mirkoruether/lathecontrol/README.md

# Pimp your lathe!
bla bla will be added later.

## Software Libraries
#### RotaryEncoder
https://github.com/mathertel/RotaryEncoder \
http://www.mathertel.de/Arduino/RotaryEncoderLibrary.aspx 

#### Display
http://www.lcdwiki.com/3.5inch_Arduino_Display-UNO#Program_Download \
https://github.com/lcdwiki/LCDWIKI_gui \
https://github.com/lcdwiki/LCDWIKI_kbv \
https://github.com/adafruit/Adafruit_TouchScreen 

## Hardware
#### Measuring Sticks (German):
https://www.wabeco-remscheid.de/catalog/category/view/s/anbaumessschieber/id/562/

#### Arduino Mega2560:
https://store.arduino.cc/arduino-mega-2560-rev3

#### Display
http://www.lcdwiki.com/3.5inch_Arduino_Display-UNO \
https://www.amazon.de/gp/product/B07K2YCSJD/ 

## Other Links
#### Very helpful project
http://www.mtahlers.de/index.php/diverses/messschieberanzeige
