mirkoruether/lathecontrol/v3_rp2040/board/lathecontrol_v3.kicad_pcb

## KiCad design v3_rp2040/board/lathecontrol_v3.kicad_pcb (2026-09-24)

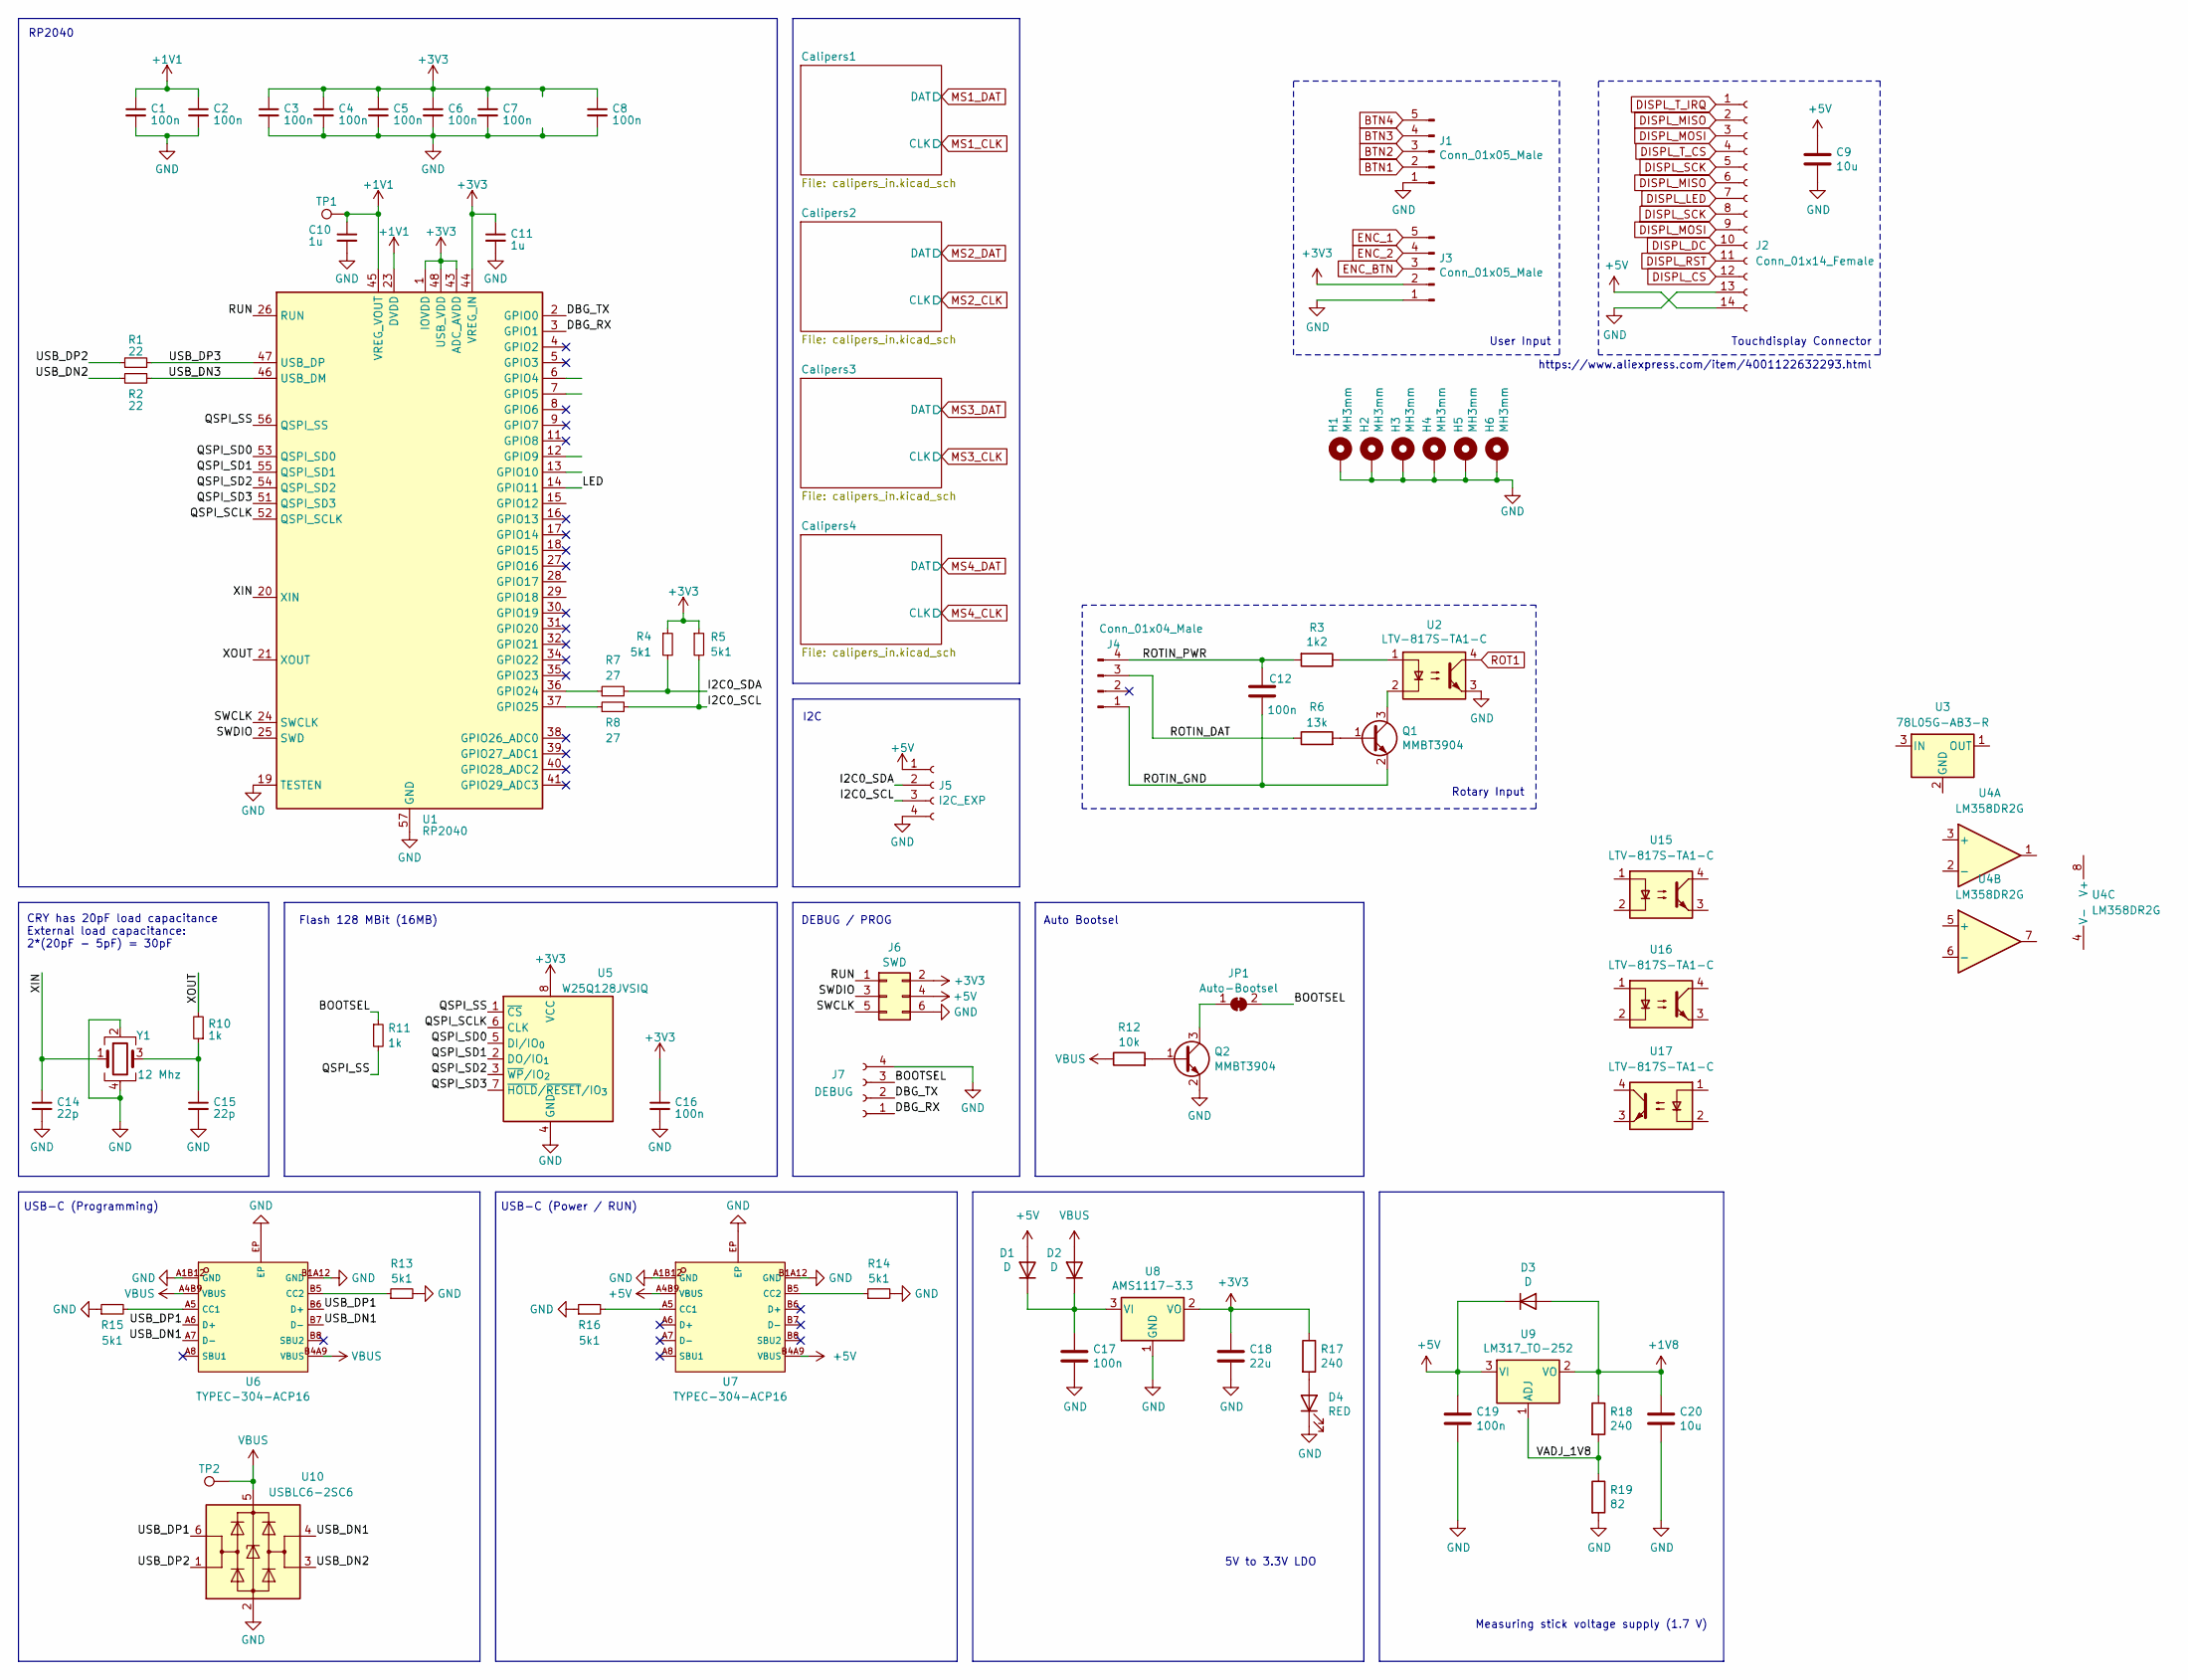
[picture p1: schematic lathecontrol_v3.kicad_sch]

Parts:
C1, C2, C3, C4, C5, C6, C7, C8, C16: 100n; C_0402_1005Metric; LCSC C1525
C9, C20: 10u; C_0805_2012Metric; LCSC C13585
C10, C11: 1u; C_0402_1005Metric; LCSC C52923
C12, C17, C19: 100n; C_0603_1608Metric; LCSC C14663
C14, C15: 22p; C_0402_1005Metric; LCSC C1555
C18: 22u; C_0805_2012Metric; LCSC C45783
D1, D2, D3: D; D_SOD-123F; LCSC C64898
D4: RED; LED_0603_1608Metric; LCSC C2286
H1, H2, H3, H4, H5, H6: MH3mm; MountingHole_3mm_Pad
J1: Conn_01x05_Male; PinHeader_1x06_P2.54mm_Horizontal
J2: Conn_01x14_Female; PinSocket_1x14_P2.54mm_Vertical
J3: Conn_01x05_Male; PinHeader_1x05_P2.54mm_Horizontal
J4: Conn_01x04_Male; PinHeader_1x04_P2.54mm_Horizontal
J5: I2C_EXP; PinHeader_1x04_P2.54mm_Vertical; LCSC C2691448
J6: SWD; PinHeader_2x03_P2.54mm_Vertical; LCSC C65114
J7: DEBUG; PinHeader_1x04_P2.54mm_Vertical; LCSC C2691448
JP1: Auto-Bootsel; R_0603_1608Metric; LCSC C21189
Q1: MMBT3904; SOT-23
Q2: MMBT3904; SOT-23; LCSC C20526
R1, R2: 22; R_0402_1005Metric; LCSC C25092
R3: 1k2; R_0805_2012Metric; LCSC C17379
R4, R5, R13, R14, R15, R16: 5k1; R_0603_1608Metric; LCSC C23186
R6: 13k; R_0603_1608Metric; LCSC C22797
R7, R8: 27; R_0603_1608Metric; LCSC C25190
R10, R11: 1k; R_0402_1005Metric; LCSC C11702
R12: 10k; R_0402_1005Metric; LCSC C25744
R17, R18: 240; R_0603_1608Metric; LCSC C23350
R19: 82; R_0603_1608Metric; LCSC C23255
TP1, TP2: TestPoint; TestPoint_Pad_D1.5mm
U1: RP2040; RP2040-QFN-56; LCSC C2040
U2, U15, U16, U17: LTV-817S-TA1-C; SMDIP-4_W9.53mm; LCSC C109227
U3: 78L05G-AB3-R; SOT-89-3; LCSC C71136
U4: LM358DR2G; SOIC-8_3.9x4.9mm_P1.27mm; LCSC C7950
U5: W25Q128JVSIQ; SOIC-8_5.3x5.3mm_P1.27mm; LCSC C97521
U6, U7: TYPEC-304-ACP16; USB-C-SMD_TYPE-C-16P-1; LCSC C2982555
U8: AMS1117-3.3; SOT-223-3_TabPin2; LCSC C6186
U9: LM317_TO-252; TO-252-2; LCSC C75510
U10: USBLC6-2SC6; SOT-23-6; LCSC C2827654
Y1: 12 Mhz; OSC-SMD_4P-L3.2-W2.5-BL; LCSC C9002

Connections:
+1V1: C1.1, C2.1, C10.1, TP1.1 (1_1), U1.23 (DVDD), U1.45 (VREG_VOUT), U1.50 (DVDD)
+1V8: C20.1, D3.2 (A), R18.1, U9.2 (VO); also elsewhere on the board
+3V3: C3.1, C4.1, C5.1, C6.1, C7.1, C8.1, C11.1, C16.1, C18.1, J3.2, J6.2, R4.1, R5.1, R17.1, U1.1 (IOVDD), U1.10 (IOVDD), U1.22 (IOVDD), U1.33 (IOVDD), U1.42 (IOVDD), U1.43 (ADC_AVDD), U1.44 (VREG_IN), U1.48 (USB_VDD), U1.49 (IOVDD), U5.8 (VCC), U8.2 (VO); also elsewhere on the board
+5V: C9.1, C19.1, D1.2 (A), D3.1 (K), J2.14, J5.1, J6.4, U7.A4B9 (VBUS), U7.B4A9 (VBUS), U9.3 (VI)
/BOOTSEL: J7.3, JP1.2 (B), R11.1
/DBG_RX: J7.1, U1.3 (GPIO1)
/DBG_TX: J7.2, U1.2 (GPIO0)
/I2C0_SCL: J5.3, R5.2, R8.2
/I2C0_SDA: J5.2, R4.2, R7.2
/LED: U1.14 (GPIO11)
/QSPI_SCLK: U1.52 (QSPI_SCLK), U5.6 (CLK)
/QSPI_SD0: U1.53 (QSPI_SD0), U5.5 (DI/IO_{0})
/QSPI_SD1: U1.55 (QSPI_SD1), U5.2 (DO/IO_{1})
/QSPI_SD2: U1.54 (QSPI_SD2), U5.3 (~WP/IO_{2})
/QSPI_SD3: U1.51 (QSPI_SD3), U5.7 (~HOLD/~RESET/IO_{3})
/QSPI_SS: R11.2, U1.56 (QSPI_SS), U5.1 (~CS)
/ROTIN_DAT: J4.3, R6.1
/ROTIN_GND: C12.2, J4.1, Q1.2 (E)
/ROTIN_PWR: C12.1, J4.4, R3.2
/RUN: J6.1, U1.26 (RUN)
/SWCLK: J6.5, U1.24 (SWCLK)
/SWDIO: J6.3, U1.25 (SWD)
/USB_DN1: U6.A7 (D-), U6.B7 (D-), U10.4 (I/O2)
/USB_DN2: R2.2, U10.3 (I/O2)
/USB_DN3: R2.1, U1.46 (USB_DM)
/USB_DP1: U6.A6 (D+), U6.B6 (D+), U10.6 (I/O1)
/USB_DP2: R1.1, U10.1 (I/O1)
/USB_DP3: R1.2, U1.47 (USB_DP)
/VADJ_1V8: R18.2, R19.1, U9.1 (ADJ)
/XIN: C14.1, U1.20 (XIN), Y1.1
/XOUT: R10.2, U1.21 (XOUT)
BTN1: J1.2
BTN2: J1.3
BTN3: J1.4
BTN4: J1.5
DISPL_CS: J2.12
DISPL_DC: J2.10
DISPL_LED: J2.7
DISPL_MISO: J2.2, J2.6
DISPL_MOSI: J2.3, J2.9
DISPL_RST: J2.11
DISPL_SCK: J2.5, J2.8
DISPL_T_CS: J2.4
DISPL_T_IRQ: J2.1
ENC_1: J3.5
ENC_2: J3.4
ENC_BTN: J3.3
GND: C1.2, C2.2, C3.2, C4.2, C5.2, C6.2, C7.2, C8.2, C9.2, C10.2, C11.2, C14.2, C15.2, C16.2, C17.2, C18.2, C19.2, C20.2, D4.1 (K), H1.1 (1_1), H2.1 (1_1), H3.1 (1_1), H4.1 (1_1), H5.1 (1_1), H6.1 (1_1), J1.1, J2.13, J3.1, J5.4, J6.6, J7.4, Q2.2 (E), R13.2, R14.2, R15.1, R16.1, R19.2, U1.19 (TESTEN), U1.57 (GND), U2.3, U5.4 (GND), U6.A1B12 (GND), U6.B1A12 (GND), U6.EP, U7.A1B12 (GND), U7.B1A12 (GND), U7.EP, U8.1 (GND), U10.2 (GND), Y1.2, Y1.4; also elsewhere on the board
unnamed: C15.1, R10.1, Y1.3
unnamed: C17.1, D1.1 (K), D2.1 (K), U8.3 (VI)
unnamed: D4.2 (A), R17.2
unnamed: JP1.1 (A), Q2.3 (C)
unnamed: Q1.1 (B), R6.2
unnamed: Q1.3 (C), U2.2
unnamed: Q2.1 (B), R12.2
unnamed: R3.1, U2.1
unnamed: R7.1, U1.36 (GPIO24)
unnamed: R8.1, U1.37 (GPIO25)
unnamed: R15.2, U6.A5 (CC1)
unnamed: R13.1, U6.B5 (CC2)
unnamed: R16.2, U7.A5 (CC1)
unnamed: R14.1, U7.B5 (CC2)
ROT1: U2.4
VBUS: D2.2 (A), R12.1, TP2.1 (1_1), U6.A4B9 (VBUS), U6.B4A9 (VBUS), U10.5 (VBUS)

Notes on the sheet:
5V to 3.3V LDO
RP2040
Rotary Input
Flash 128 MBit (16MB)
https://www.aliexpress.com/item/4001122632293.html
USB-C (Programming)
Touchdisplay Connector
I2C
CRY has 20pF load capacitance External load capacitance: 2*(20pF - 5pF) = 30pF
Measuring stick voltage supply (1.7 V)
Auto Bootsel
USB-C (Power / RUN)
User Input
DEBUG / PROG

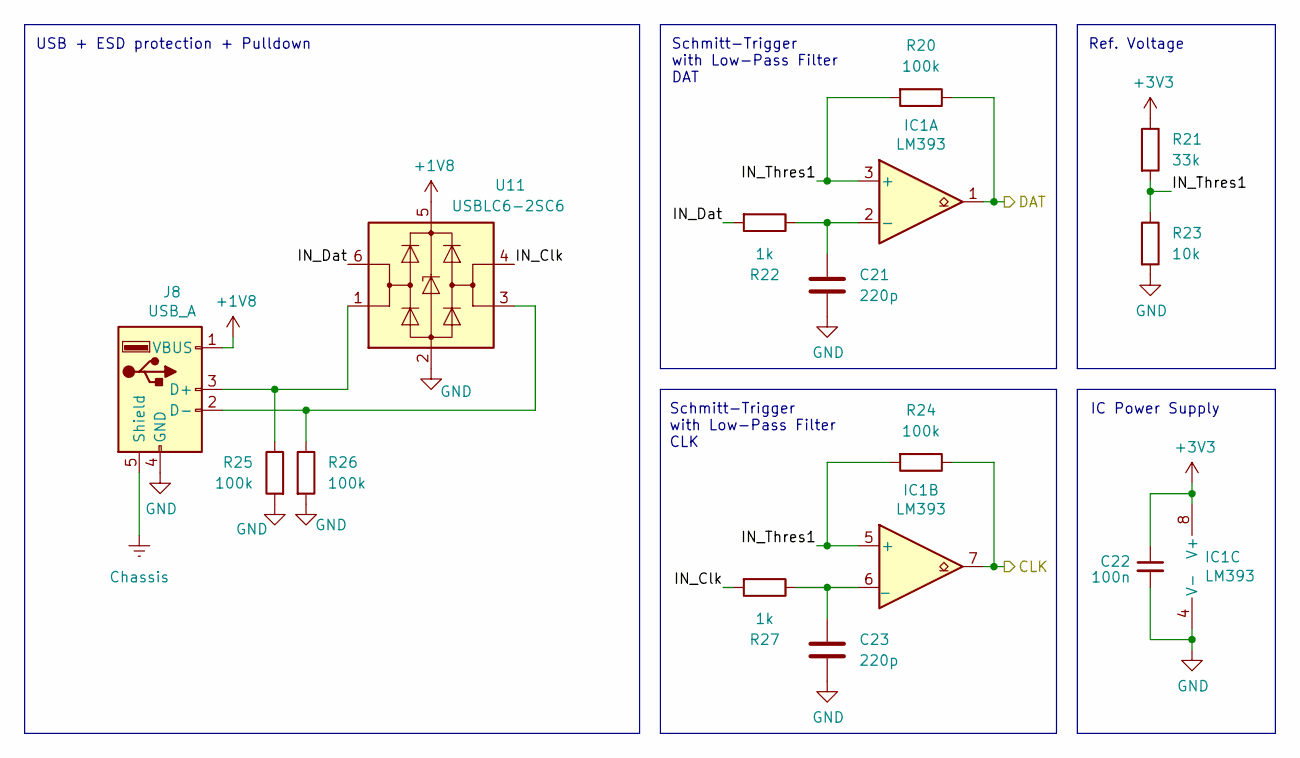
[picture p2: schematic calipers_in.kicad_sch]

Parts:
C21, C23: 220p; C_0402_1005Metric; LCSC C1530
C22: 100n; C_0402_1005Metric; LCSC C1525
IC1: LM393; SOIC-8_3.9x4.9mm_P1.27mm
J8: USB_A; USB_A_Upright_C26235; LCSC C26235
R20, R24, R25, R26: 100k; R_0402_1005Metric; LCSC C25741
R21: 33k; R_0402_1005Metric; LCSC C25779
R22, R27: 1k; R_0402_1005Metric; LCSC C11702
R23: 10k; R_0402_1005Metric; LCSC C25744
U11: USBLC6-2SC6; SOT-23-6; LCSC C2827654

Connections:
+1V8: J8.1 (VBUS), U11.5 (VBUS); also elsewhere on the board
+3V3: C22.1, IC1.8 (V+), R21.1; also elsewhere on the board
/Calipers1/IN_Clk: R27.2, U11.4 (I/O2)
/Calipers1/IN_Dat: R22.2, U11.6 (I/O1)
/Calipers1/IN_Thres1: IC1.3 (+), IC1.5 (+), R20.2, R21.2, R23.1, R24.2
Chassis: J8.5 (Shield); also elsewhere on the board
GND: C21.2, C22.2, C23.2, IC1.4 (V-), J8.4 (GND), R23.2, R25.2, R26.2, U11.2 (GND); also elsewhere on the board
MS1_CLK: IC1.7, R24.1
MS1_DAT: IC1.1, R20.1
unnamed: C21.1, IC1.2 (-), R22.1
unnamed: C23.1, IC1.6 (_), R27.1
unnamed: J8.3 (D+), R25.1, U11.1 (I/O1)
unnamed: J8.2 (D-), R26.1, U11.3 (I/O2)

Parts of its further copies:
C24, C26, C27, C29, C30, C32: 220p; C_0402_1005Metric; LCSC C1530
C25, C28, C31: 100n; C_0402_1005Metric; LCSC C1525
IC2, IC3, IC4: LM393; SOIC-8_3.9x4.9mm_P1.27mm
J9, J10, J11: USB_A; USB_A_Upright_C26235; LCSC C26235
R28, R32, R33, R34, R36, R40, R41, R42, R44, R48, R49, R50: 100k; R_0402_1005Metric; LCSC C25741
R29, R37, R45: 33k; R_0402_1005Metric; LCSC C25779
R30, R35, R38, R43, R46, R51: 1k; R_0402_1005Metric; LCSC C11702
R31, R39, R47: 10k; R_0402_1005Metric; LCSC C25744
U12, U13, U14: USBLC6-2SC6; SOT-23-6; LCSC C2827654

Connections of its further copies:
+1V8: J9.1 (VBUS), J10.1 (VBUS), J11.1 (VBUS), U12.5 (VBUS), U13.5 (VBUS), U14.5 (VBUS); also elsewhere on the board
+3V3: C25.1, C28.1, C31.1, IC2.8 (V+), IC3.8 (V+), IC4.8 (V+), R29.1, R37.1, R45.1; also elsewhere on the board
/Calipers2/IN_Clk: R35.2, U12.4 (I/O2)
/Calipers2/IN_Dat: R30.2, U12.6 (I/O1)
/Calipers2/IN_Thres1: IC2.3 (+), IC2.5 (+), R28.2, R29.2, R31.1, R32.2
/Calipers3/IN_Clk: R43.2, U13.4 (I/O2)
/Calipers3/IN_Dat: R38.2, U13.6 (I/O1)
/Calipers3/IN_Thres1: IC3.3 (+), IC3.5 (+), R36.2, R37.2, R39.1, R40.2
/Calipers4/IN_Clk: R51.2, U14.4 (I/O2)
/Calipers4/IN_Dat: R46.2, U14.6 (I/O1)
/Calipers4/IN_Thres1: IC4.3 (+), IC4.5 (+), R44.2, R45.2, R47.1, R48.2
Chassis: J9.5 (Shield), J10.5 (Shield), J11.5 (Shield); also elsewhere on the board
GND: C24.2, C25.2, C26.2, C27.2, C28.2, C29.2, C30.2, C31.2, C32.2, IC2.4 (V-), IC3.4 (V-), IC4.4 (V-), J9.4 (GND), J10.4 (GND), J11.4 (GND), R31.2, R33.2, R34.2, R39.2, R41.2, R42.2, R47.2, R49.2, R50.2, U12.2 (GND), U13.2 (GND), U14.2 (GND); also elsewhere on the board
MS2_CLK: IC2.7, R32.1
MS2_DAT: IC2.1, R28.1
MS3_CLK: IC3.7, R40.1
MS3_DAT: IC3.1, R36.1
MS4_CLK: IC4.7, R48.1
MS4_DAT: IC4.1, R44.1
unnamed: C24.1, IC2.2 (-), R30.1
unnamed: C26.1, IC2.6 (_), R35.1
unnamed: C27.1, IC3.2 (-), R38.1
unnamed: C29.1, IC3.6 (_), R43.1
unnamed: C30.1, IC4.2 (-), R46.1
unnamed: C32.1, IC4.6 (_), R51.1
unnamed: J9.3 (D+), R33.1, U12.1 (I/O1)
unnamed: J9.2 (D-), R34.1, U12.3 (I/O2)
unnamed: J10.3 (D+), R41.1, U13.1 (I/O1)
unnamed: J10.2 (D-), R42.1, U13.3 (I/O2)
unnamed: J11.3 (D+), R49.1, U14.1 (I/O1)
unnamed: J11.2 (D-), R50.1, U14.3 (I/O2)

Notes on the sheet:
IC Power Supply
Schmitt-Trigger with Low-Pass Filter DAT
USB + ESD protection + Pulldown
Schmitt-Trigger with Low-Pass Filter CLK
Ref. Voltage

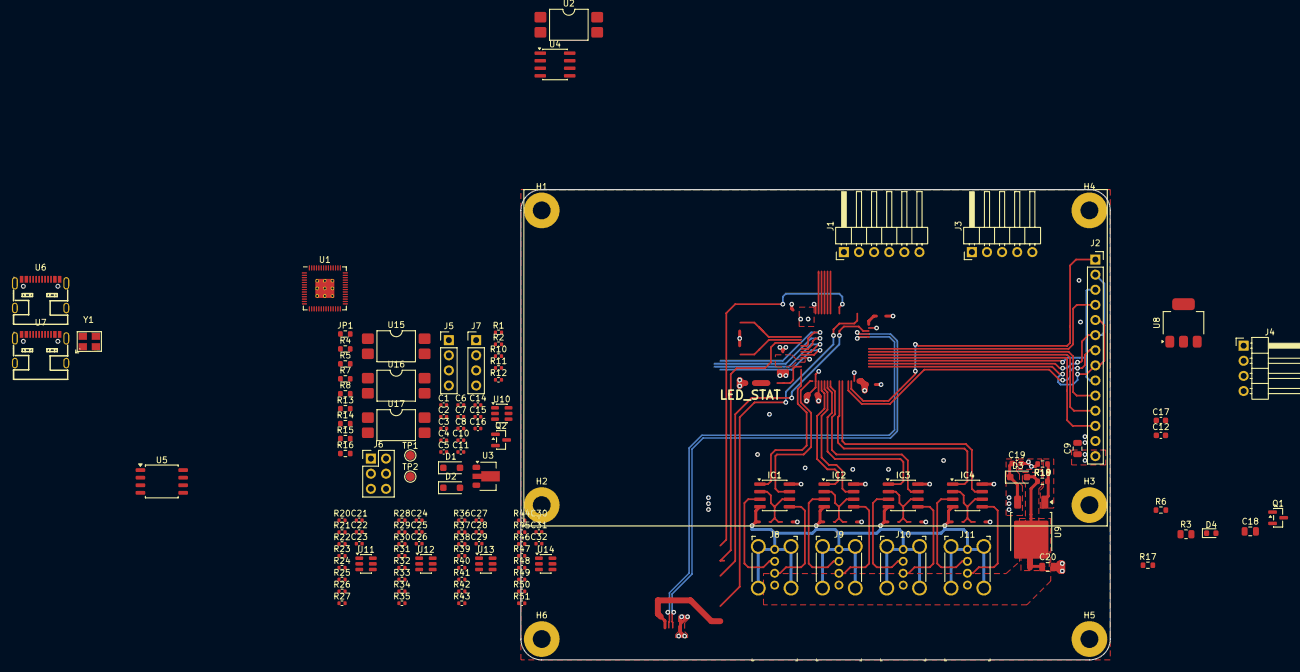
[picture p3: board lathecontrol_v3.kicad_pcb from above]

Board: 4 copper layers, 99.0 x 79.0 mm, 129 parts (0 on the bottom side), 86 nets.
