mirkoruether/lathecontrol/v2_stm32/board/lathecontrol_v2.kicad_pcb

## KiCad design v2_stm32/board/lathecontrol_v2.kicad_pcb (2022-01-29)

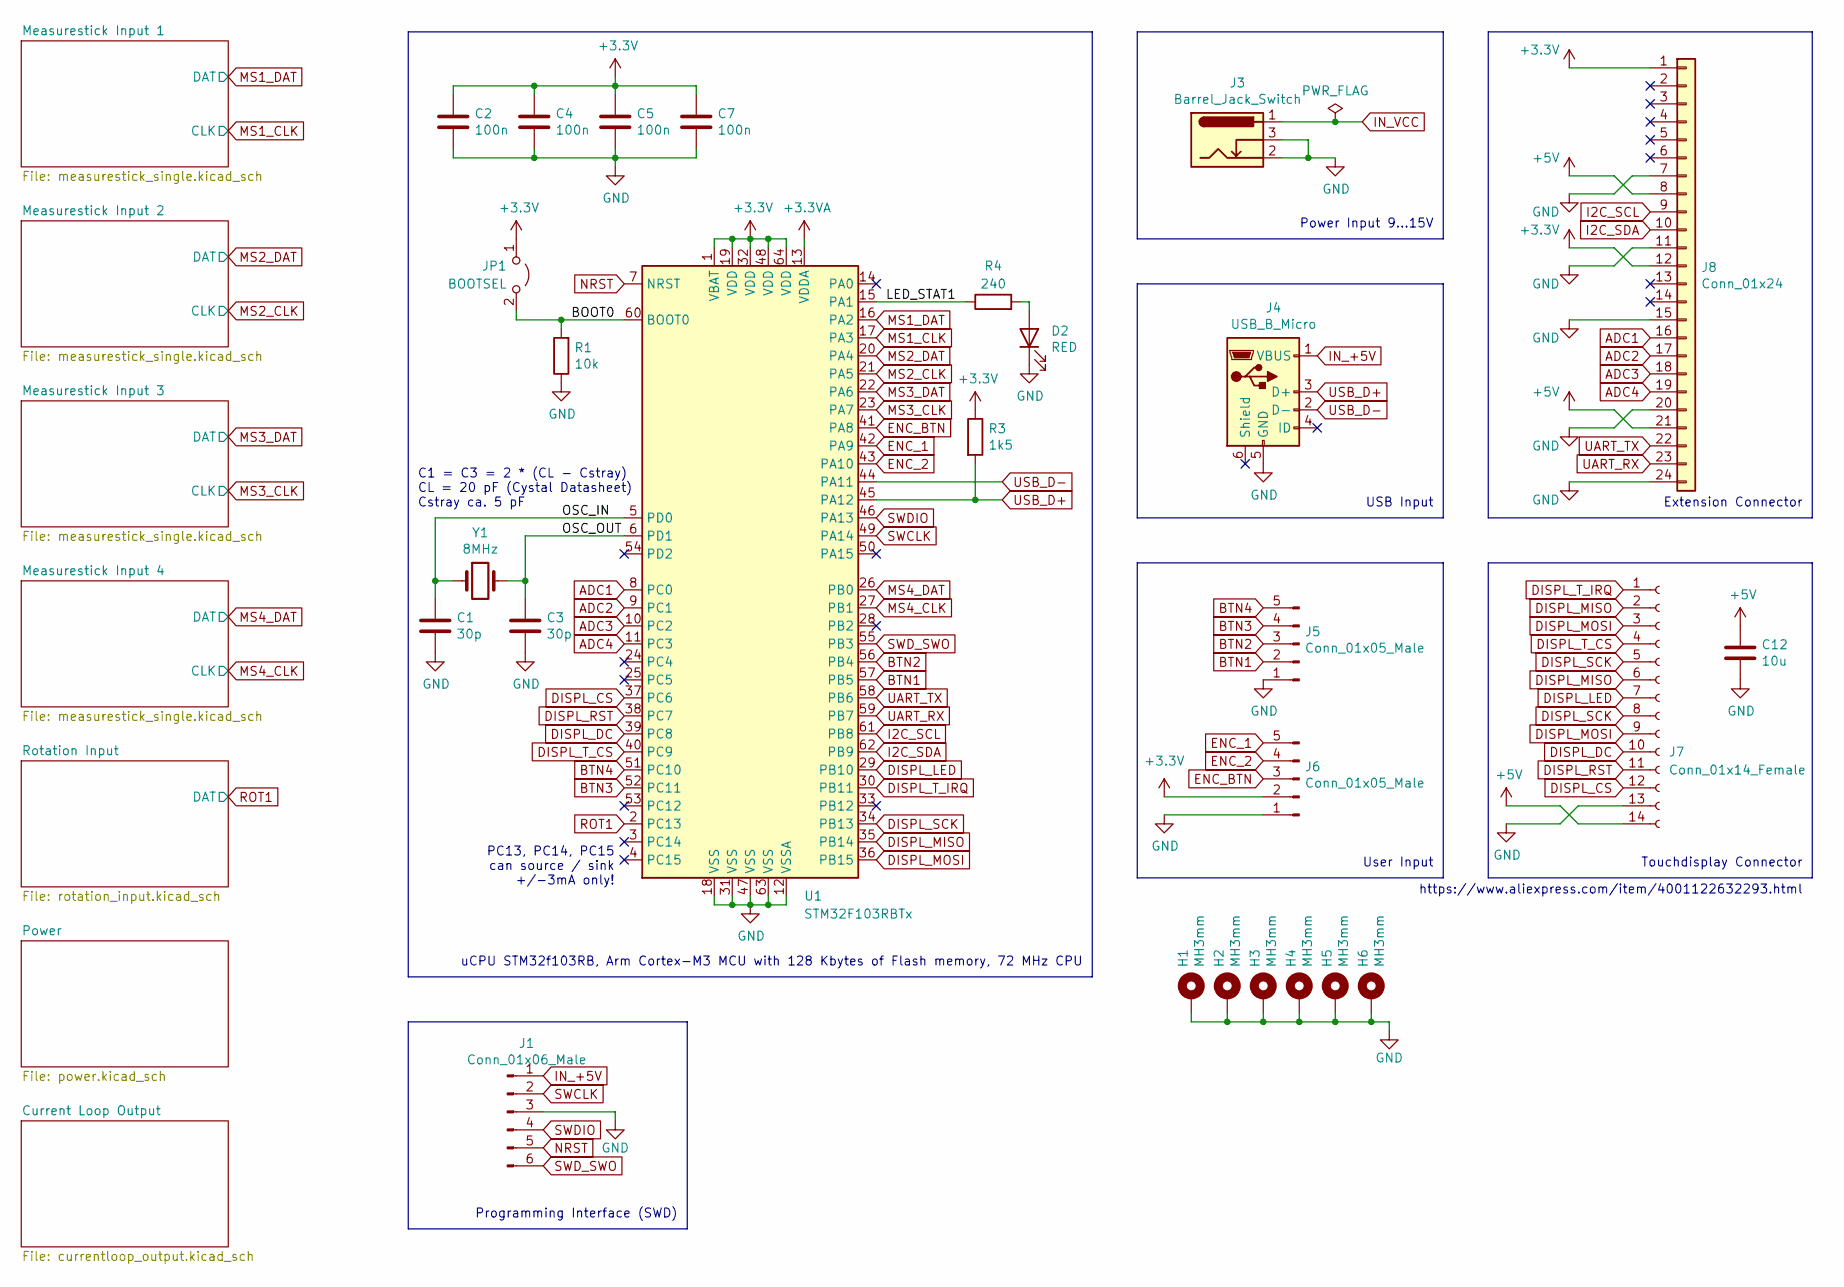
[picture p4: schematic lathecontrol_v2.kicad_sch]

Parts:
C1, C3: 30p; C_0603_1608Metric; LCSC C22397
C2, C4, C5, C7: 100n; C_0603_1608Metric; LCSC C14663
C12: 10u; C_0805_2012Metric; LCSC C13585
D2: RED; LED_0603_1608Metric; LCSC C2286
H1, H2, H3, H4, H5, H6: MH3mm; MountingHole_3mm_Pad
J1: Conn_01x06_Male; PinHeader_1x06_P2.54mm_Vertical
J3: Barrel_Jack_Switch; BarrelJack_Horizontal_DC-005-20A; LCSC C136744
J4: USB_B_Micro; USB_Micro-B_SHOU_HAN_MicroXNJ; LCSC C404969
J5: Conn_01x05_Male; PinHeader_1x06_P2.54mm_Horizontal
J6: Conn_01x05_Male; PinHeader_1x05_P2.54mm_Horizontal
J7: Conn_01x14_Female; PinSocket_1x14_P2.54mm_Vertical
J8: Conn_01x24; FFC_FPC_1x24_DualSide_JUSHUO_AFC24-S24FIC-00; LCSC C262292
JP1: BOOTSEL; PinHeader_1x02_P2.54mm_Horizontal
R1: 10k; R_0603_1608Metric; LCSC C25804
R3: 1k5; R_0603_1608Metric; LCSC C22843
R4: 240; R_0603_1608Metric; LCSC C23350
U1: STM32F103RBTx; LQFP-64_10x10mm_P0.5mm
Y1: 8MHz; Crystal_SMD_5032-2Pin_5.0x3.2mm; LCSC C115962

Connections:
+3.3VA: U1.13 (VDDA); also elsewhere on the board
+3V3: C2.1, C4.1, C5.1, C7.1, J6.2, J8.1, J8.12, JP1.1 (A), R3.1, U1.1 (VBAT), U1.19 (VDD), U1.32 (VDD), U1.48 (VDD), U1.64 (VDD); also elsewhere on the board
+5V: C12.1, J7.14, J8.8, J8.21; also elsewhere on the board
/BOOT0: JP1.2 (B), R1.2, U1.60 (BOOT0)
/LED_STAT1: R4.1, U1.15 (PA1)
/OSC_IN: C1.1, U1.5 (PD0), Y1.1
/OSC_OUT: C3.1, U1.6 (PD1), Y1.2
ADC1: J8.16, U1.8 (PC0)
ADC2: J8.17, U1.9 (PC1)
ADC3: J8.18, U1.10 (PC2)
ADC4: J8.19, U1.11 (PC3)
BTN1: J5.2, U1.57 (PB5)
BTN2: J5.3, U1.56 (PB4)
BTN3: J5.4, U1.52 (PC11)
BTN4: J5.5, U1.51 (PC10)
DISPL_CS: J7.12, U1.37 (PC6)
DISPL_DC: J7.10, U1.39 (PC8)
DISPL_LED: J7.7, U1.29 (PB10)
DISPL_MISO: J7.2, J7.6, U1.35 (PB14)
DISPL_MOSI: J7.3, J7.9, U1.36 (PB15)
DISPL_RST: J7.11, U1.38 (PC7)
DISPL_SCK: J7.5, J7.8, U1.34 (PB13)
DISPL_T_CS: J7.4, U1.40 (PC9)
DISPL_T_IRQ: J7.1, U1.30 (PB11)
ENC_1: J6.5, U1.42 (PA9)
ENC_2: J6.4, U1.43 (PA10)
ENC_BTN: J6.3, U1.41 (PA8)
GND: C1.2, C2.2, C3.2, C4.2, C5.2, C7.2, C12.2, D2.1 (K), H1.1, H2.1, H3.1, H4.1, H5.1, H6.1, J1.3, J3.2, J3.3, J4.5 (GND), J5.1, J6.1, J7.13, J8.7, J8.11, J8.15, J8.20, J8.24, R1.1, U1.12 (VSSA), U1.18 (VSS), U1.31 (VSS), U1.47 (VSS), U1.63 (VSS); also elsewhere on the board
I2C_SCL: J8.9, U1.61 (PB8)
I2C_SDA: J8.10, U1.62 (PB9)
IN_+5V: J1.1, J4.1 (VBUS); also elsewhere on the board
IN_VCC: J3.1; also elsewhere on the board
MS1_CLK: U1.17 (PA3); also elsewhere on the board
MS1_DAT: U1.16 (PA2); also elsewhere on the board
MS2_CLK: U1.21 (PA5); also elsewhere on the board
MS2_DAT: U1.20 (PA4); also elsewhere on the board
MS3_CLK: U1.23 (PA7); also elsewhere on the board
MS3_DAT: U1.22 (PA6); also elsewhere on the board
MS4_CLK: U1.27 (PB1); also elsewhere on the board
MS4_DAT: U1.26 (PB0); also elsewhere on the board
NRST: J1.5, U1.7 (NRST)
unnamed: D2.2 (A), R4.2
ROT1: U1.2 (PC13); also elsewhere on the board
SWCLK: J1.2, U1.49 (PA14)
SWDIO: J1.4, U1.46 (PA13)
SWD_SWO: J1.6, U1.55 (PB3)
UART_RX: J8.23, U1.59 (PB7)
UART_TX: J8.22, U1.58 (PB6)
USB_D+: J4.3 (D+), R3.2, U1.45 (PA12)
USB_D-: J4.2 (D-), U1.44 (PA11)

Notes on the sheet:
PC13, PC14, PC15 can source / sink +/-3mA only!
https://www.aliexpress.com/item/4001122632293.html
USB Input
Touchdisplay Connector
Power Input 9...15V
Programming Interface (SWD)
uCPU STM32f103RB, Arm Cortex-M3 MCU with 128 Kbytes of Flash memory, 72 MHz CPU
User Input
Extension Connector
C1 = C3 = 2 * (CL - Cstray) CL = 20 pF (Cystal Datasheet) Cstray ca. 5 pF

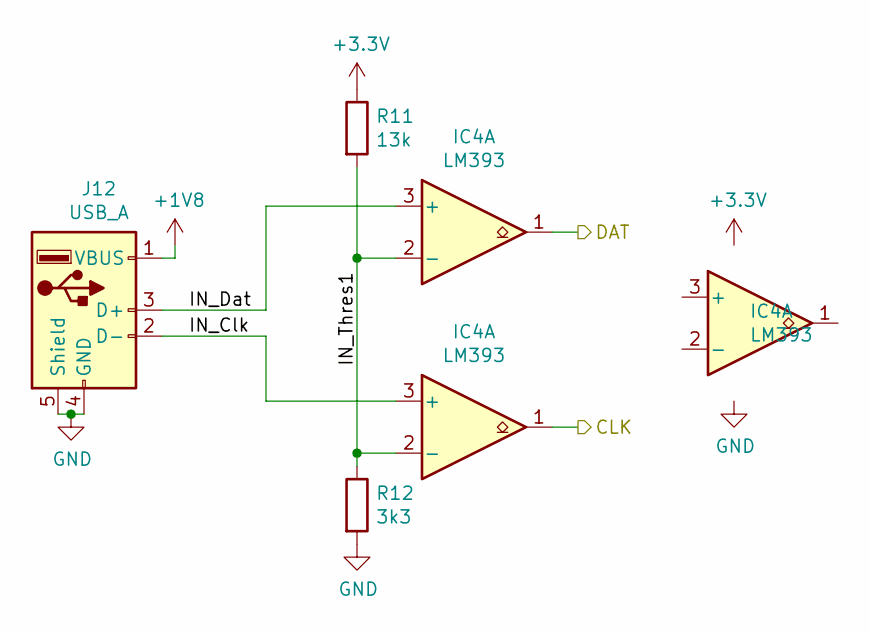
[picture p5: schematic measurestick_single.kicad_sch]

Parts:
IC4: LM393; SOIC-8_3.9x4.9mm_P1.27mm
J12: USB_A; USB_A_Upright_C26235; LCSC C26235
R11: 13k; R_0603_1608Metric; LCSC C22797
R12: 3k3; R_0603_1608Metric; LCSC C22978

Connections:
+1V8: J12.1 (VBUS); also elsewhere on the board
+3V3: IC4.8 (V+), R11.1; also elsewhere on the board
/Measurestick Input 4/IN_Thres1: IC4.2 (-), IC4.6 (_), R11.2, R12.1
GND: IC4.4 (V-), J12.4 (GND), J12.5 (Shield), R12.2; also elsewhere on the board
MS4_CLK: IC4.7; also elsewhere on the board
MS4_DAT: IC4.1; also elsewhere on the board

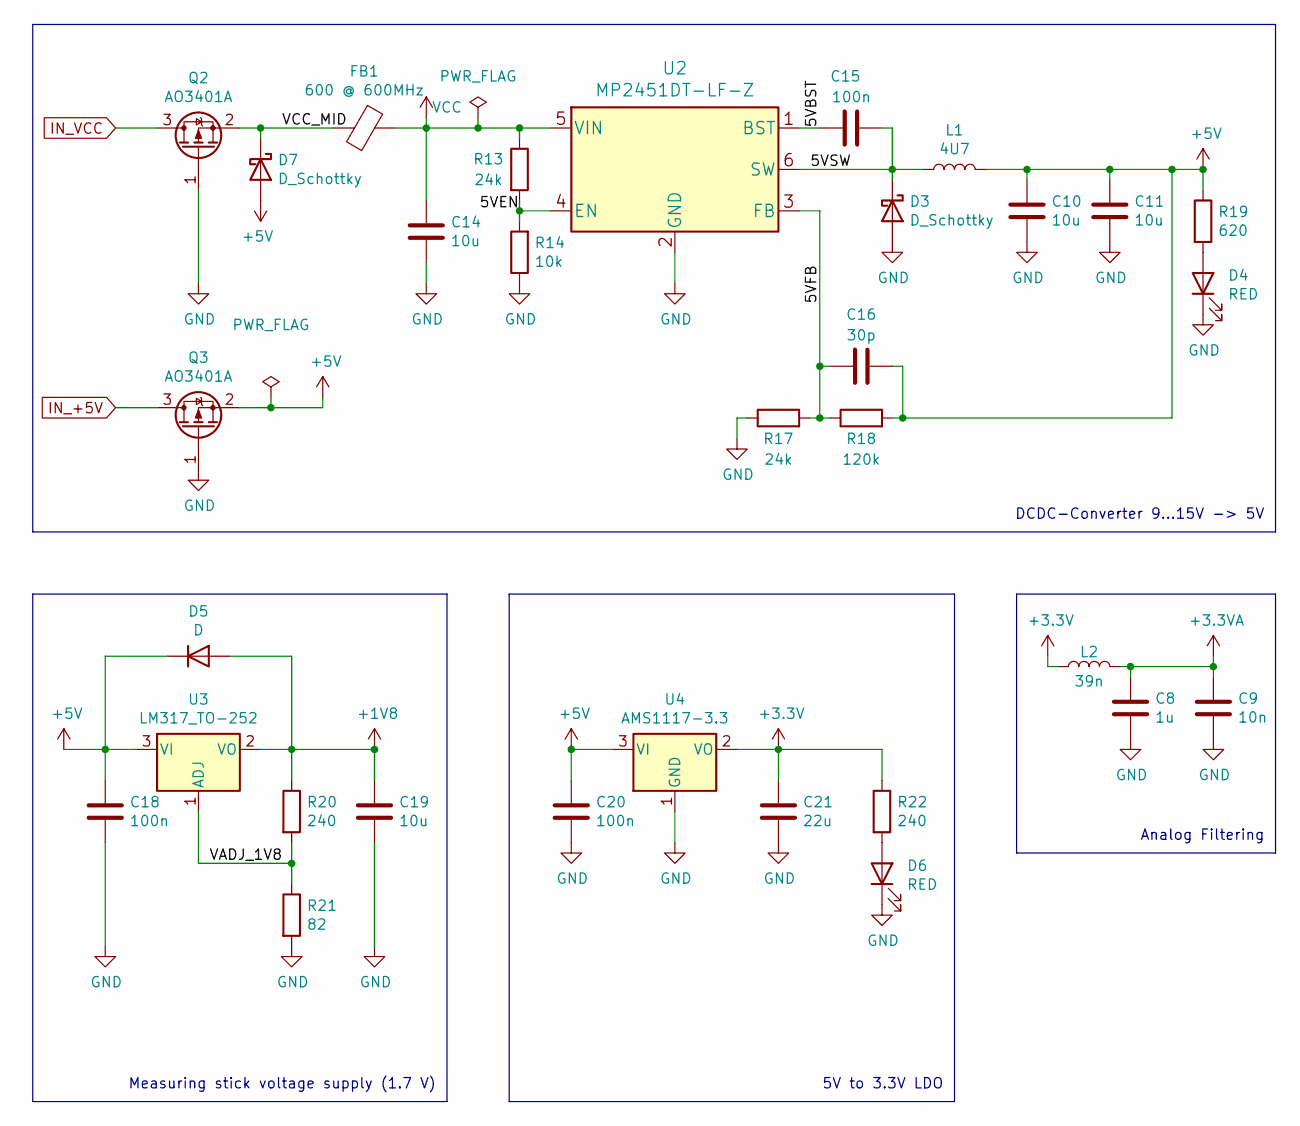
[picture p6: schematic power.kicad_sch]

Parts:
C8: 1u; L_0402_1005Metric; LCSC C52923
C9: 10n; L_0402_1005Metric; LCSC C15195
C10, C11, C14, C19: 10u; C_0805_2012Metric; LCSC C13585
C15, C18, C20: 100n; C_0603_1608Metric; LCSC C14663
C16: 30p; C_0603_1608Metric; LCSC C22397
C21: 22u; C_0805_2012Metric; LCSC C45783
D3, D7: D_Schottky; D_SOD-123; LCSC C8598
D4, D6: RED; LED_0603_1608Metric; LCSC C2286
D5: D; D_SOD-123F; LCSC C64898
FB1: 600 @ 600MHz; L_0805_2012Metric; LCSC C1017
L1: 4U7; L_3012_SMD3.0x3.0x1.2mm; MFR_Part SWPA3012S4R7MT; LCSC C83415
L2: 39n; L_0402_1005Metric; LCSC C26443
Q2, Q3: AO3401A; SOT-23; LCSC C15127
R13, R17: 24k; R_0603_1608Metric; LCSC C23352
R14: 10k; R_0603_1608Metric; LCSC C25804
R18: 120k; R_0603_1608Metric; LCSC C25808
R19: 620; R_0603_1608Metric; LCSC C23220
R20, R22: 240; R_0603_1608Metric; LCSC C23350
R21: 82; R_0603_1608Metric; LCSC C23255
U2: MP2451DT-LF-Z; SOT-23-6; LCSC C14123
U3: LM317_TO-252; TO-252-2; LCSC C75510
U4: AMS1117-3.3; SOT-223-3_TabPin2; LCSC C6186

Connections:
+1V8: C19.1, D5.2 (A), R20.1, U3.2 (VO); also elsewhere on the board
+3.3VA: C8.1, C9.1, L2.2; also elsewhere on the board
+3V3: C21.1, L2.1, R22.1, U4.2 (VO); also elsewhere on the board
+5V: C10.1, C11.1, C16.2, C18.1, C20.1, D5.1 (K), D7.2 (A), L1.2, Q3.2 (S), R18.2, R19.1, U3.3 (VI), U4.3 (VI); also elsewhere on the board
/Power/5VBST: C15.1, U2.1 (BST)
/Power/5VEN: R13.2, R14.2, U2.4 (EN)
/Power/5VFB: C16.1, R17.2, R18.1, U2.3 (FB)
/Power/5VSW: C15.2, D3.1 (K), L1.1, U2.6 (SW)
/Power/VADJ_1V8: R20.2, R21.1, U3.1 (ADJ)
/Power/VCC_MID: D7.1 (K), FB1.2, Q2.2 (S)
GND: C8.2, C9.2, C10.2, C11.2, C14.2, C18.2, C19.2, C20.2, C21.2, D3.2 (A), D4.1 (K), D6.1 (K), Q2.1 (G), Q3.1 (G), R14.1, R17.1, R21.2, U2.2 (GND), U4.1 (GND); also elsewhere on the board
IN_+5V: Q3.3 (D); also elsewhere on the board
IN_VCC: Q2.3 (D); also elsewhere on the board
unnamed: D4.2 (A), R19.2
unnamed: D6.2 (A), R22.2
VCC: C14.1, FB1.1, R13.1, U2.5 (VIN)

Notes on the sheet:
5V to 3.3V LDO
Measuring stick voltage supply (1.7 V)
Analog Filtering
DCDC-Converter 9...15V -> 5V

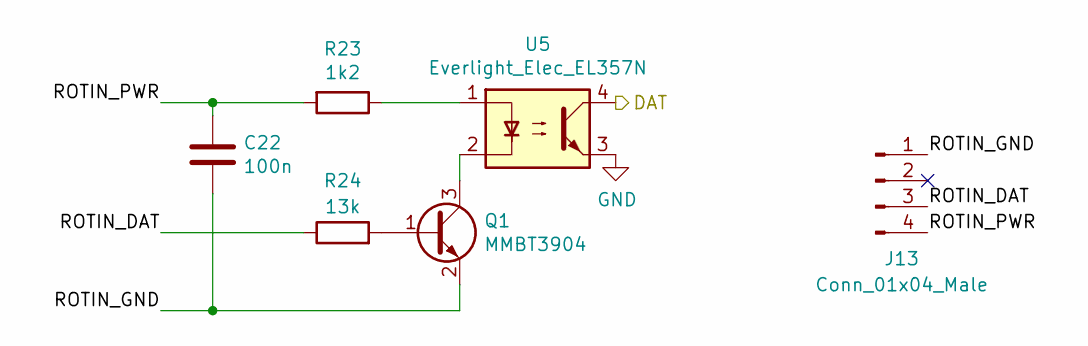
[picture p7: schematic rotation_input.kicad_sch]

Parts:
C22: 100n; C_0603_1608Metric; LCSC C14663
J13: Conn_01x04_Male; PinHeader_1x04_P2.54mm_Horizontal
Q1: MMBT3904; SOT-23
R23: 1k2; R_0805_2012Metric; LCSC C17379
R24: 13k; R_0603_1608Metric; LCSC C22797
U5: Everlight_Elec_EL357N; SOP-4_4.1x4.4x2.54P; LCSC C6649

Connections:
/Rotation Input/ROTIN_DAT: J13.3, R24.1
/Rotation Input/ROTIN_GND: C22.2, J13.1, Q1.2 (E)
/Rotation Input/ROTIN_PWR: C22.1, J13.4, R23.2
GND: U5.3; also elsewhere on the board
unnamed: Q1.1 (B), R24.2
unnamed: Q1.3 (C), U5.2
unnamed: R23.1, U5.1
ROT1: U5.4; also elsewhere on the board

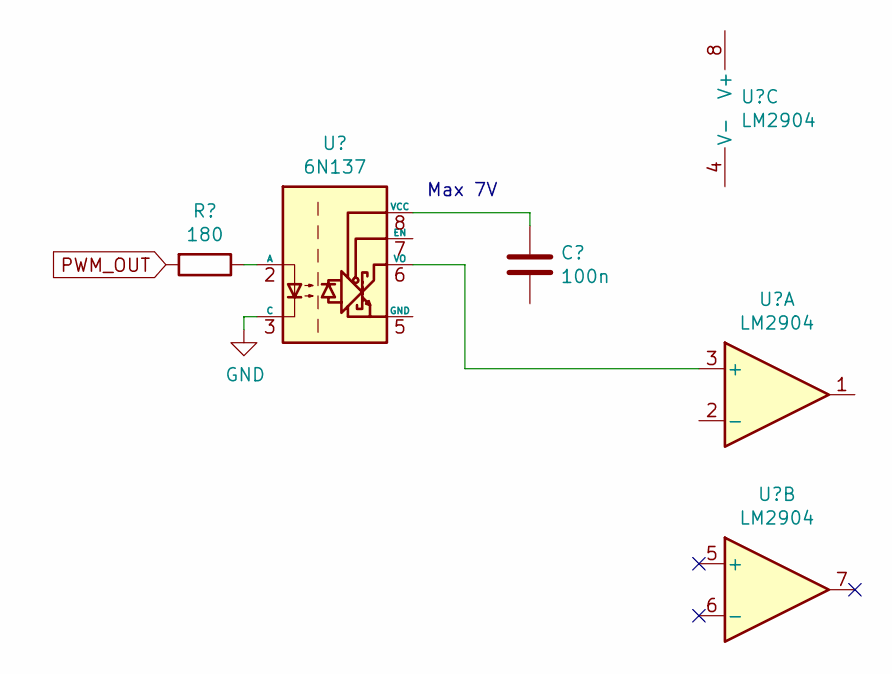
[picture p8: schematic currentloop_output.kicad_sch]

Notes on the sheet:
Max 7V

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
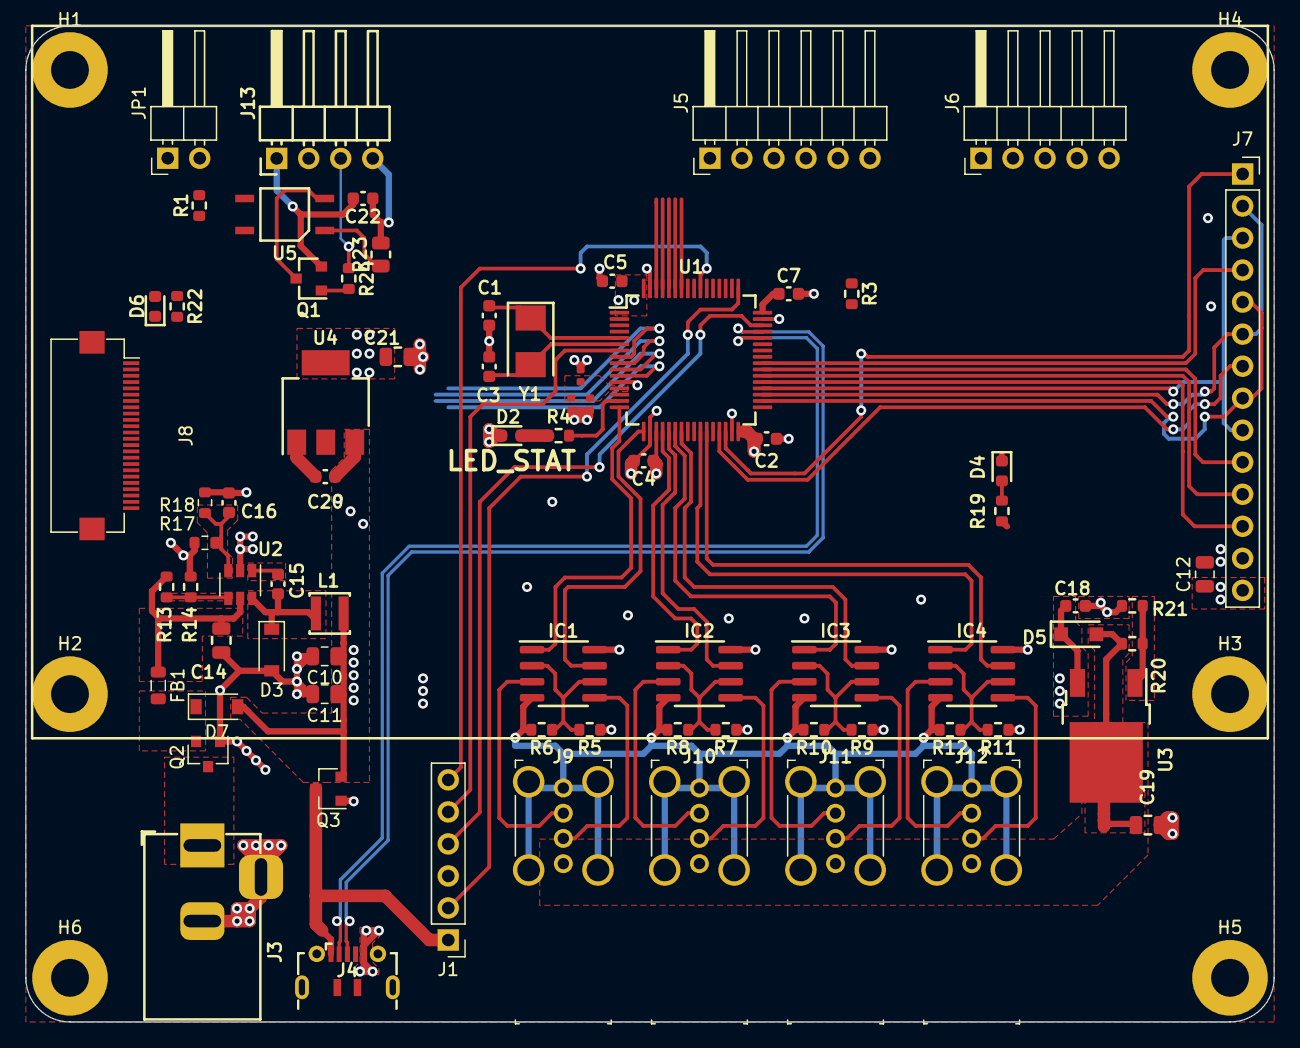
[picture p9: board lathecontrol_v2.kicad_pcb from above]

Board: 4 copper layers, 99.0 x 79.0 mm, 81 parts (0 on the bottom side), 78 nets.

Other parts of the board:
IC1, IC2, IC3: LM393; SOIC-8_3.9x4.9mm_P1.27mm
J9, J10, J11: USB_A; USB_A_Upright_C26235
R5, R7, R9: 13k; R_0603_1608Metric
R6, R8, R10: 3k3; R_0603_1608Metric

Their connections:
+1V8: J9.1, J10.1, J11.1; also elsewhere on the board
+3V3: IC1.8, IC2.8, IC3.8, R5.1, R7.1, R9.1; also elsewhere on the board
/Measurestick Input 1/IN_Clk: IC1.5, J9.2
/Measurestick Input 1/IN_Dat: IC1.3, J9.3
/Measurestick Input 1/IN_Thres1: IC1.2, IC1.6, R5.2, R6.1
/Measurestick Input 2/IN_Clk: IC2.5, J10.2
/Measurestick Input 2/IN_Dat: IC2.3, J10.3
/Measurestick Input 2/IN_Thres1: IC2.2, IC2.6, R7.2, R8.1
/Measurestick Input 3/IN_Clk: IC3.5, J11.2
/Measurestick Input 3/IN_Dat: IC3.3, J11.3
/Measurestick Input 3/IN_Thres1: IC3.2, IC3.6, R9.2, R10.1
GND: IC1.4, IC2.4, IC3.4, J9.4, J9.5, J10.4, J10.5, J11.4, J11.5, R6.2, R8.2, R10.2; also elsewhere on the board
MS1_CLK: IC1.7; also elsewhere on the board
MS1_DAT: IC1.1; also elsewhere on the board
MS2_CLK: IC2.7; also elsewhere on the board
MS2_DAT: IC2.1; also elsewhere on the board
MS3_CLK: IC3.7; also elsewhere on the board
MS3_DAT: IC3.1; also elsewhere on the board
