mirkoruether/lathecontrol/v1_arduino_mega/board/measurestick.kicad_pcb

## KiCad design v1_arduino_mega/board/measurestick.kicad_pcb (2020-12-27)

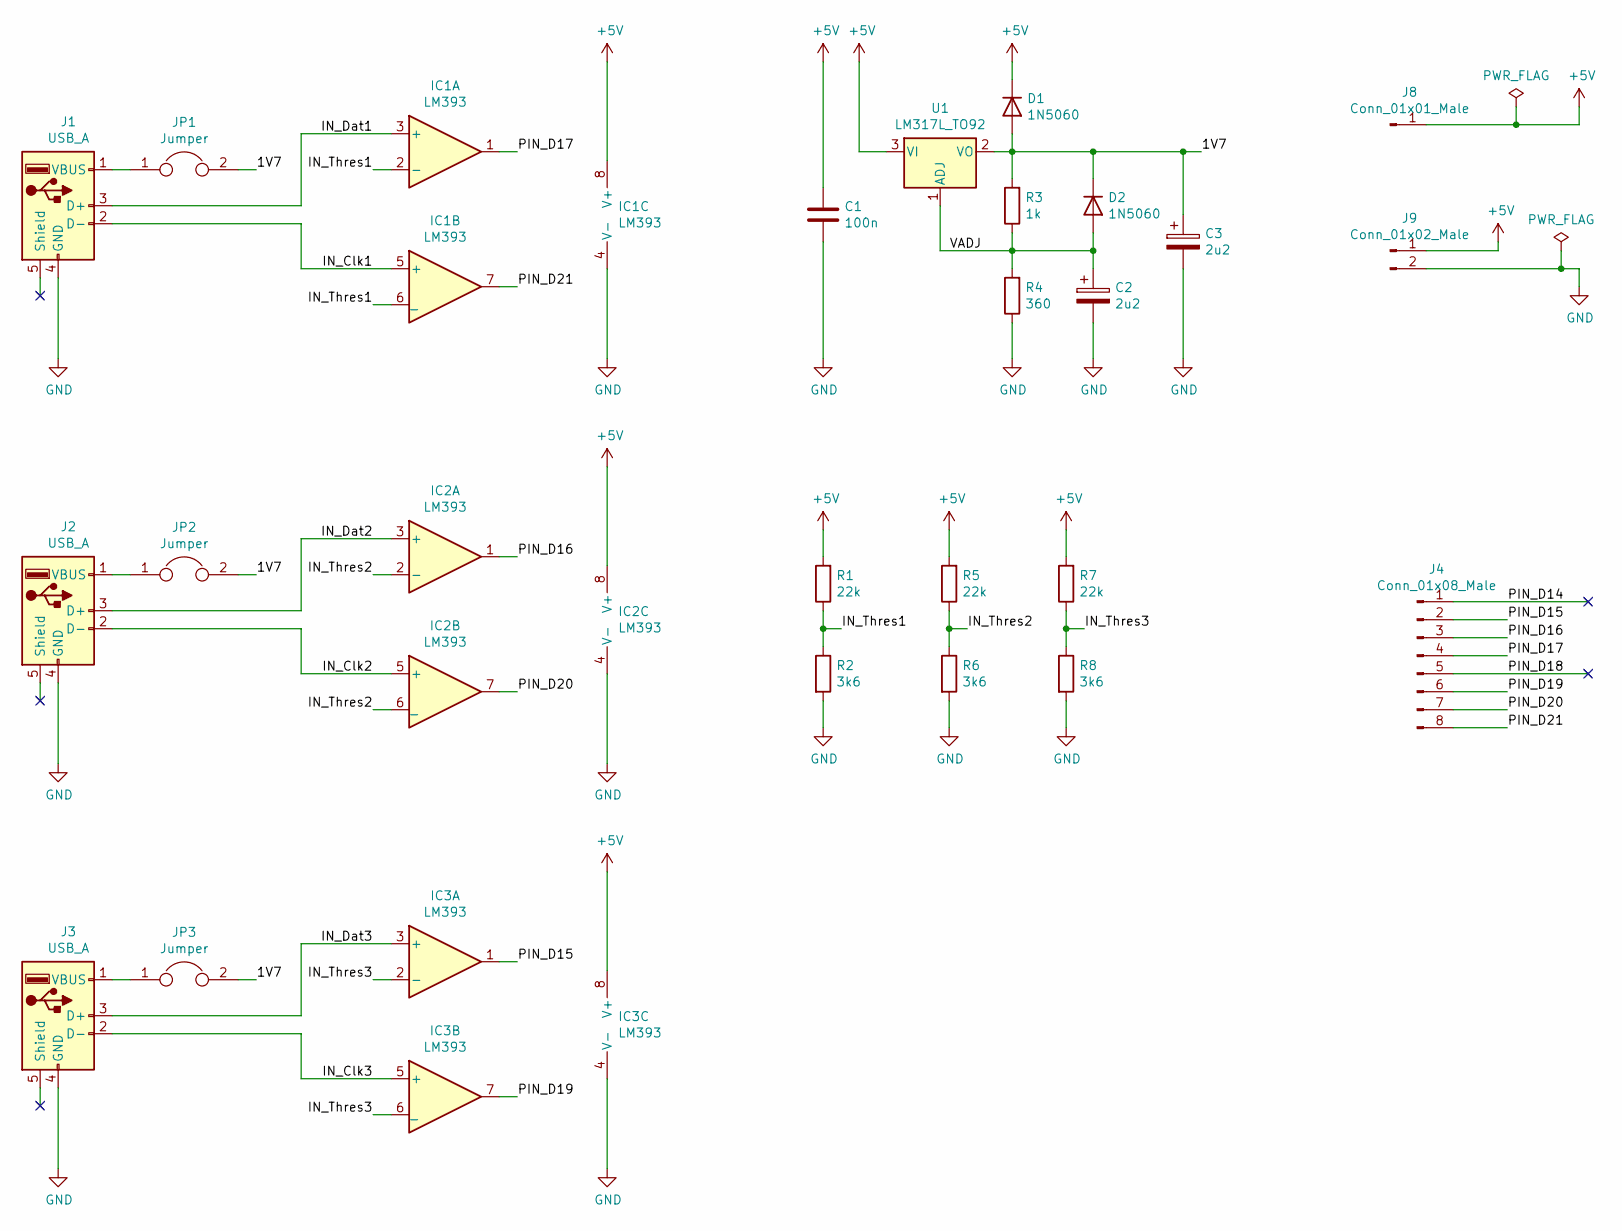
[picture p10: schematic measurestick.sch, Lathecontrol-Addon for Ardunio Mega 2560]

Parts:
C1: 100n; C_Disc_D5.0mm_W2.5mm_P2.50mm
C2, C3: 2u2; CP_Radial_D4.0mm_P1.50mm
D1, D2: 1N5060; D_DO-15_P12.70mm_Horizontal
IC1, IC2, IC3: LM393; DIP-8_W7.62mm
J1, J2, J3: USB_A; USB_A_Molex_67643_Horizontal
J4: Conn_01x08_Male; PinHeader_1x08_P2.54mm_Vertical
J8: Conn_01x01_Male; PinHeader_1x01_P2.54mm_Vertical
J9: Conn_01x02_Male; PinHeader_1x02_P2.54mm_Horizontal
JP1, JP2, JP3: Jumper; PinHeader_1x02_P2.54mm_Horizontal
R1, R5, R7: 22k; R_Axial_DIN0207_L6.3mm_D2.5mm_P10.16mm_Horizontal
R2, R6, R8: 3k6; R_Axial_DIN0207_L6.3mm_D2.5mm_P10.16mm_Horizontal
R3: 1k; R_Axial_DIN0207_L6.3mm_D2.5mm_P10.16mm_Horizontal
R4: 360; R_Axial_DIN0207_L6.3mm_D2.5mm_P10.16mm_Horizontal
U1: LM317L_TO92; TO-92_Inline

Connections:
+5V: C1.1, D1.1 (K), IC1.8 (V+), IC2.8 (V+), IC3.8 (V+), J8.1, J9.1, R1.2, R5.2, R7.2, U1.3 (VI)
/1V7: C3.1, D1.2 (A), D2.1 (K), JP1.2, JP2.2, JP3.2, R3.2, U1.2 (VO)
/IN_Clk1: IC1.5 (+), J1.2 (D-)
/IN_Clk2: IC2.5 (+), J2.2 (D-)
/IN_Clk3: IC3.5 (+), J3.2 (D-)
/IN_Dat1: IC1.3 (+), J1.3 (D+)
/IN_Dat2: IC2.3 (+), J2.3 (D+)
/IN_Dat3: IC3.3 (+), J3.3 (D+)
/IN_Thres1: IC1.2 (-), IC1.6 (_), R1.1, R2.1
/IN_Thres2: IC2.2 (-), IC2.6 (_), R5.1, R6.1
/IN_Thres3: IC3.2 (-), IC3.6 (_), R7.1, R8.1
/PIN_D14: J4.1
/PIN_D15: IC3.1, J4.2
/PIN_D16: IC2.1, J4.3
/PIN_D17: IC1.1, J4.4
/PIN_D18: J4.5
/PIN_D19: IC3.7, J4.6
/PIN_D20: IC2.7, J4.7
/PIN_D21: IC1.7, J4.8
/VADJ: C2.1, D2.2 (A), R3.1, R4.2, U1.1 (ADJ)
GND: C1.2, C2.2, C3.2, IC1.4 (V-), IC2.4 (V-), IC3.4 (V-), J1.4 (GND), J2.4 (GND), J3.4 (GND), J9.2, R2.2, R4.1, R6.2, R8.2
unnamed: J1.1 (VBUS), JP1.1
unnamed: J2.1 (VBUS), JP2.1
unnamed: J3.1 (VBUS), JP3.1

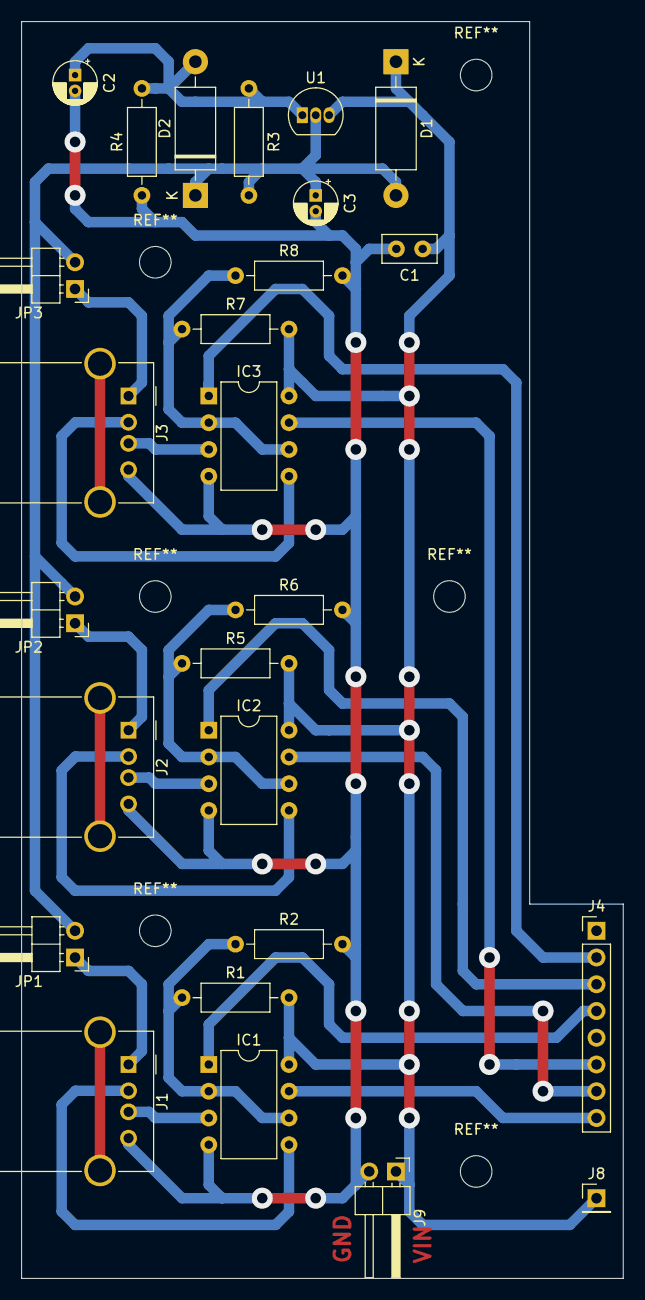
[picture p11: board measurestick.kicad_pcb from above]

Board: 2 copper layers, 57.2 x 119.4 mm, 26 parts (0 on the bottom side), 22 nets.
