mirkoruether/lathecontrol/v1_arduino_mega/board/userinput.kicad_pcb

## KiCad design v1_arduino_mega/board/userinput.kicad_pcb (2020-12-27)

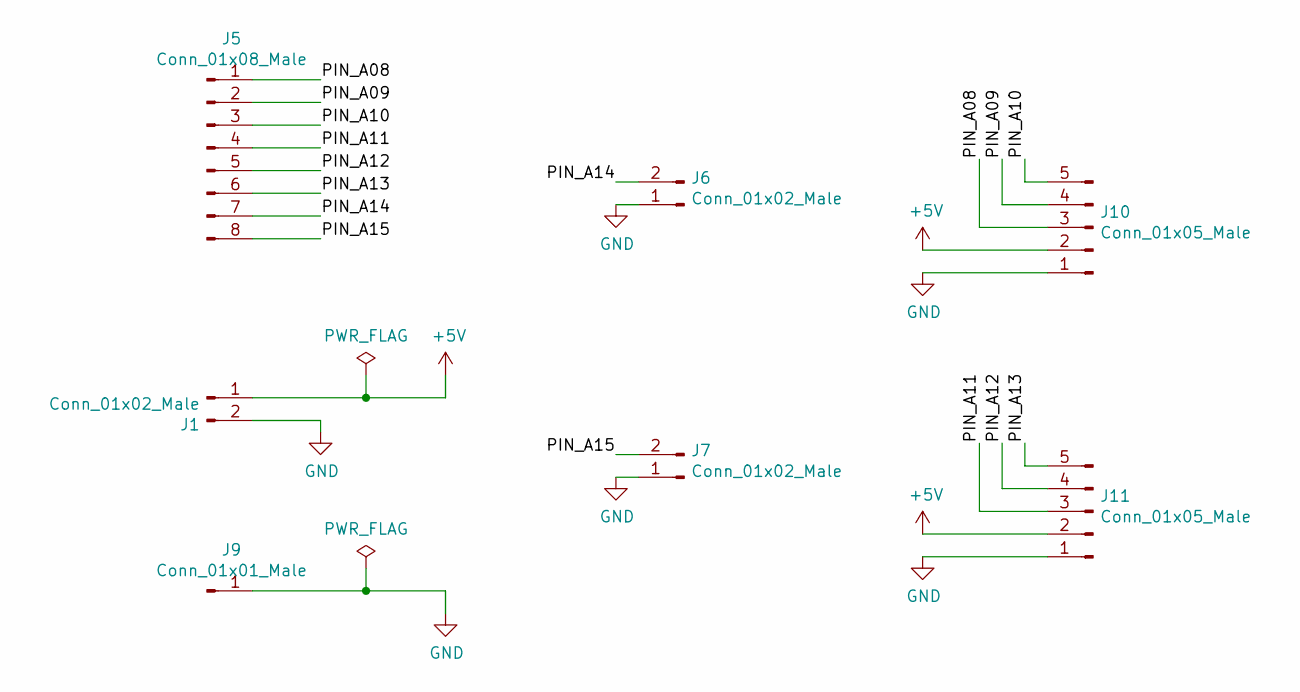
[picture p12: schematic userinput.sch, Lathecontrol-Addon for Ardunio Mega 2560]

Parts:
J1, J6, J7: Conn_01x02_Male; PinHeader_1x02_P2.54mm_Horizontal
J5: Conn_01x08_Male; PinHeader_1x08_P2.54mm_Vertical
J9: Conn_01x01_Male; PinHeader_1x01_P2.54mm_Vertical
J10, J11: Conn_01x05_Male; PinHeader_1x05_P2.54mm_Horizontal

Connections:
+5V: J1.1, J10.2, J11.2
/PIN_A08: J5.1, J10.3
/PIN_A09: J5.2, J10.4
/PIN_A10: J5.3, J10.5
/PIN_A11: J5.4, J11.3
/PIN_A12: J5.5, J11.4
/PIN_A13: J5.6, J11.5
/PIN_A14: J5.7, J6.2
/PIN_A15: J5.8, J7.2
GND: J1.2, J6.1, J7.1, J9.1, J10.1, J11.1

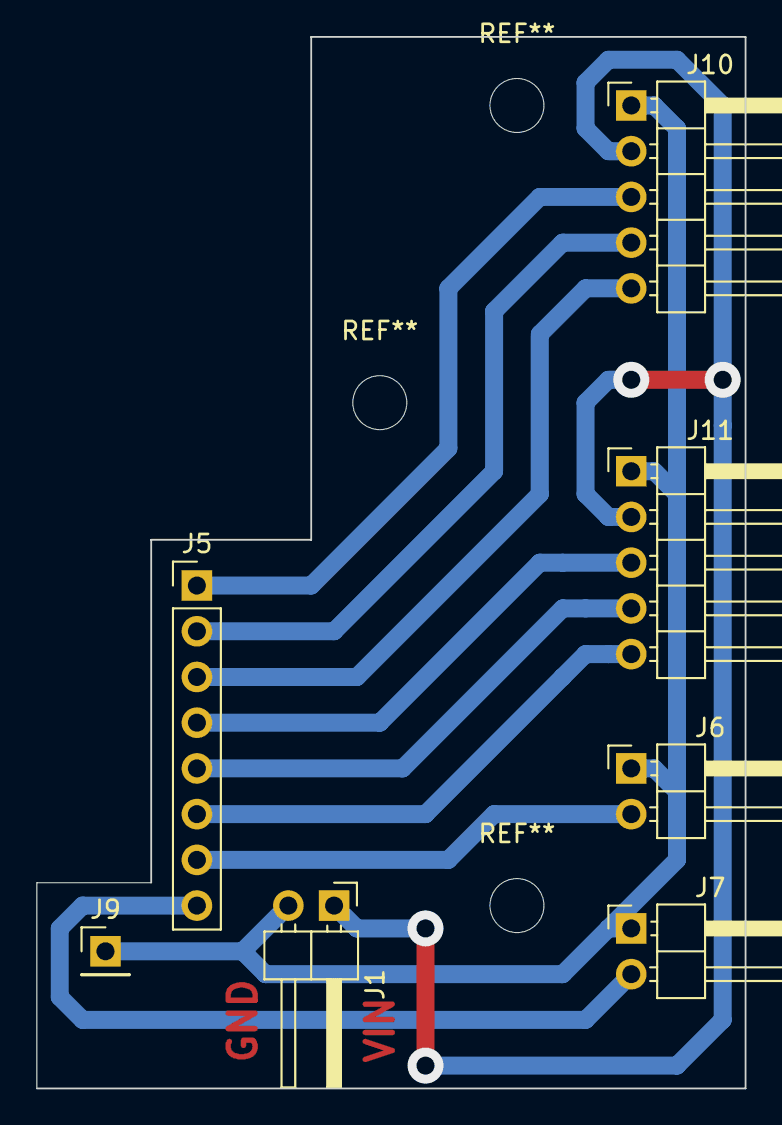
[picture p13: board userinput.kicad_pcb from above]

Board: 2 copper layers, 39.4 x 58.4 mm, 7 parts (0 on the bottom side), 10 nets.
