mirkoruether/lathecontrol/v2_custom_pcb/board/measurestick_single.kicad_sch

## KiCad design v2_custom_pcb/board/measurestick_single.kicad_sch (2022-01-29)


Parts:
IC4: LM393; SOIC-8_3.9x4.9mm_P1.27mm
J12: USB_A; USB_A_Upright_C26235; LCSC C26235
R11: 13k; R_0603_1608Metric; LCSC C22797
R12: 3k3; R_0603_1608Metric; LCSC C22978

Connections:
+1V8: J12.1 (VBUS)
+3.3V: R11.1
CLK: IC4.1
DAT: IC4.1
GND: J12.4 (GND), J12.5 (Shield), R12.2
IN_Clk: IC4.3 (+), J12.2 (D-)
IN_Dat: IC4.3 (+), J12.3 (D+)
IN_Thres1: IC4.2 (-), R11.2, R12.1
