mirkoruether/lathecontrol/v2_custom_pcb/board/power.kicad_sch

## KiCad design v2_custom_pcb/board/power.kicad_sch (2022-01-29)


Parts:
C8: 1u; L_0402_1005Metric; LCSC C52923
C9: 10n; L_0402_1005Metric; LCSC C15195
C10, C11, C14, C19: 10u; C_0805_2012Metric; LCSC C13585
C15, C18, C20: 100n; C_0603_1608Metric; LCSC C14663
C16: 30p; C_0603_1608Metric; LCSC C22397
C21: 22u; C_0805_2012Metric; LCSC C45783
D3, D7: D_Schottky; D_SOD-123; LCSC C8598
D4, D6: RED; LED_0603_1608Metric; LCSC C2286
D5: D; D_SOD-123F; LCSC C64898
FB1: 600 @ 600MHz; L_0805_2012Metric; LCSC C1017
L1: 4U7; L_3012_SMD3.0x3.0x1.2mm; MFR_Part SWPA3012S4R7MT; LCSC C83415
L2: 39n; L_0402_1005Metric; LCSC C26443
Q2, Q3: AO3401A; SOT-23; LCSC C15127
R13, R17: 24k; R_0603_1608Metric; LCSC C23352
R14: 10k; R_0603_1608Metric; LCSC C25804
R18: 120k; R_0603_1608Metric; LCSC C25808
R19: 620; R_0603_1608Metric; LCSC C23220
R20, R22: 240; R_0603_1608Metric; LCSC C23350
R21: 82; R_0603_1608Metric; LCSC C23255
U2: MP2451DT-LF-Z; SOT-23-6; LCSC C14123
U3: LM317_TO-252; TO-252-2; LCSC C75510
U4: AMS1117-3.3; SOT-223-3_TabPin2; LCSC C6186

Connections:
5VBST: C15.1, U2.1 (BST)
5VEN: R13.2, R14.2, U2.4 (EN)
5VFB: C16.1, R17.2, R18.1, U2.3 (FB)
5VSW: C15.2, D3.1 (K), L1.1, U2.6 (SW)
+1V8: C19.1, D5.2 (A), R20.1, U3.2 (VO)
+3.3V: C21.1, L2.1, R22.1, U4.2 (VO)
+3.3VA: C8.1, C9.1, L2.2
+5V: C10.1, C11.1, C16.2, C18.1, C20.1, D5.1 (K), D7.2 (A), L1.2, Q3.2 (S), R18.2, R19.1, U3.3 (VI), U4.3 (VI)
GND: C8.2, C9.2, C10.2, C11.2, C14.2, C18.2, C19.2, C20.2, C21.2, D3.2 (A), D4.1 (K), D6.1 (K), Q2.1 (G), Q3.1 (G), R14.1, R17.1, R21.2, U2.2 (GND), U4.1 (GND)
IN_+5V: Q3.3 (D)
IN_VCC: Q2.3 (D)
unnamed: D4.2 (A), R19.2
unnamed: D6.2 (A), R22.2
VADJ_1V8: R20.2, R21.1, U3.1 (ADJ)
VCC: C14.1, FB1.1, R13.1, U2.5 (VIN)
VCC_MID: D7.1 (K), FB1.2, Q2.2 (S)

Notes on the sheet:
5V to 3.3V LDO
Measuring stick voltage supply (1.7 V)
Analog Filtering
DCDC-Converter 9...15V -> 5V
