mirkoruether/lathecontrol/v2_custom_pcb/board/rotation_input.kicad_sch

## KiCad design v2_custom_pcb/board/rotation_input.kicad_sch (2022-01-29)


Parts:
C22: 100n; C_0603_1608Metric; LCSC C14663
J13: Conn_01x04_Male; PinHeader_1x04_P2.54mm_Horizontal
Q1: MMBT3904; SOT-23
R23: 1k2; R_0805_2012Metric; LCSC C17379
R24: 13k; R_0603_1608Metric; LCSC C22797
U5: Everlight_Elec_EL357N; SOP-4_4.1x4.4x2.54P; LCSC C6649

Connections:
DAT: U5.4
GND: U5.3
unnamed: Q1.1 (B), R24.2
unnamed: Q1.3 (C), U5.2
unnamed: R23.1, U5.1
ROTIN_DAT: J13.3, R24.1
ROTIN_GND: C22.2, J13.1, Q1.2 (E)
ROTIN_PWR: C22.1, J13.4, R23.2
