mirkoruether/lathecontrol/v2_custom_pcb/board/STM32F103RxTx.ioc

Mcu.UserName=STM32F103RBTx
PC10.Signal=GPIO_Input
PC0.GPIO_Label=ADC1
PC6.GPIO_Label=OUT_DSIPL_CS
PA6.GPIO_Label=IN_MS3_DAT
PB0.GPIO_Label=IN_MS4_DAT
PB11.Signal=GPXTI11
PB13.Signal=SPI2_SCK
PB15.Signal=SPI2_MOSI
PD1-OSC_OUT.Signal=RCC_OSC_OUT
PA12.Signal=USB_DP
PB6.Signal=USART1_TX
PC7.Signal=GPIO_Output
PC3.Signal=ADCx_IN13
PB1.GPIO_Label=EXTI_MS4_CLK
PC11.GPIO_Label=IN_BTN3
PA10.GPIO_Label=EXTI_ENC_2
PB7.Signal=USART1_RX
PA8.Signal=GPIO_Input
PB9.Signal=I2C1_SDA
PB1.Signal=GPXTI1
PA6.Signal=GPIO_Input
PA2.GPIO_Label=IN_MS1_DAT
PA10.Signal=GPXTI10
PB5.GPIO_Label=IN_BTN1
PA4.GPIO_Label=IN_MS2_DAT
PC2.GPIO_Label=ADC3
PB4.Signal=GPIO_Input
PA3.Signal=GPXTI3
PC10.GPIO_Label=IN_BTN4
PC9.GPIO_Label=OUT_DISPL_T_CS
PA9.GPIO_Label=EXTI_ENC_1
PC11.Signal=GPIO_Input
PC8.Signal=GPIO_Output
PC2.Signal=ADCx_IN12
PC6.Signal=GPIO_Output
PB11.GPIO_Label=EXTI_DISPL_TOUCH
PC13-TAMPER-RTC.Signal=GPXTI13
PD0-OSC_IN.Signal=RCC_OSC_IN
PC0.Signal=ADCx_IN10
PC8.GPIO_Label=OUT_DISPL_DC
PA13.Signal=SYS_JTMS-SWDIO
PA8.GPIO_Label=IN_ENC_BTN
PB10.GPIO_Label=PWM_DISPL_LED
PA9.Signal=GPXTI9
PA1.Signal=GPIO_Output
PB10.Signal=GPIO_Analog
PB14.Signal=SPI2_MISO
PA5.Signal=GPXTI5
PC13-TAMPER-RTC.GPIO_Label=EXTI_ROT
PB4.GPIO_Label=IN_BTN2
PA1.GPIO_Label=LED_STAT2
PC1.GPIO_Label=ADC2
PA2.Signal=GPIO_Input
PC7.GPIO_Label=OUT_DISPL_RST
PB3.Signal=SYS_JTDO-TRACESWO
PA4.Signal=GPIO_Input
PB5.Signal=GPIO_Input
PA7.GPIO_Label=EXTI_MS3_CLK
PA5.GPIO_Label=EXTI_MS2_CLK
PA11.Signal=USB_DM
PA14.Signal=SYS_JTCK-SWCLK
PB8.Signal=I2C1_SCL
PC3.GPIO_Label=ADC4
PC9.Signal=GPIO_Output
PB0.Signal=GPIO_Input
PC1.Signal=ADCx_IN11
PA3.GPIO_Label=EXTI_MS1_CLK
PA7.Signal=GPXTI7
