mirkoruether/lathecontrol/(commit log)

2020-05-26 Added simple rotary encoder test
2020-12-27 Added KiCAD files
    [measurestick.kicad_pcb, measurestick.sch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]
2020-12-27 Added KiCad lib files
2020-12-29 Moved source code to sub folder "arduino"
2020-12-31 Interrupt attachment with template programming
2021-01-03 Gui "thread"safe and bool if new data avaiable after pushing bit to measuring stick
2021-02-10 Moved everything to v1 folder.
    [measurestick.kicad_pcb, measurestick.sch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]
2021-02-10 Started schematic for STM32 version
    [lathecontrol_stm32.kicad_pcb, lathecontrol_stm32.sch, measurestick_single.sch]
2021-02-15 STM32 board: Power supply
    [lathecontrol_stm32.sch, measurestick_single.sch, power.sch]
2021-02-15 Switched to 64 pin STM32F103. Assigned pins
    [lathecontrol_stm32.sch, measurestick_single.sch, power.sch]
2021-02-20 Added connectors
    [lathecontrol_stm32.sch, measurestick_single.sch, power.sch]
2021-02-20 Added LEDs
    [lathecontrol_stm32.sch, measurestick_single.sch, power.sch]
2021-02-21 Schematic finished (V0.1), Added footprints
    [lathecontrol_stm32.sch, measurestick_single.sch, power.sch, rotation_input.sch]
2021-02-22 Changed MS DAT/CLK pins. Routed measuring stick input
    [lathecontrol_stm32.kicad_pcb, lathecontrol_stm32.sch, measurestick_single.sch]
2021-02-22 More routing
    [lathecontrol_stm32.kicad_pcb, measurestick_single.sch, power.sch, rotation_input.sch]
2021-02-23 MP2451 Routing according to datasheet
    [lathecontrol_stm32.kicad_pcb, measurestick_single.sch, power.sch]
2021-02-23 Optimized measuring stick input
    [lathecontrol_stm32.kicad_pcb]
2021-02-28 Added stm32 pin config .ioc file
2021-03-14 More PCB design
    [lathecontrol_stm32.kicad_pcb, lathecontrol_stm32.sch, measurestick_single.sch, power.sch]
2021-03-14 Moved to 4 layer PCB. More routing
    [lathecontrol_stm32.kicad_pcb, lathecontrol_stm32.sch, measurestick_single.sch]
2021-03-29 Started current loop output for frequency converter
    [currentloop_output.sch, lathecontrol_stm32.kicad_pcb, lathecontrol_stm32.sch, measurestick_single.sch, power.sch, rotation_input.sch]
2022-01-29 Migrate to Kicad 6
    [currentloop_output.kicad_sch, currentloop_output.sch, lathecontrol_stm32.kicad_pcb, lathecontrol_stm32.kicad_sch, lathecontrol_stm32.sch, measurestick_single.kicad_sch, measurestick_single.sch, power.kicad_sch]
2022-01-29 Rename from stm32 to v2 custom pcb
    [currentloop_output.kicad_sch, lathecontrol_v2.kicad_pcb, lathecontrol_v2.kicad_sch, measurestick_single.kicad_sch, power.kicad_sch, rotation_input.kicad_sch]
2026-09-15 v3 initial stuff
    [currentloop_output.kicad_sch, lathecontrol_v2.kicad_pcb, lathecontrol_v2.kicad_sch, lathecontrol_v3.kicad_pcb, lathecontrol_v3.kicad_sch, measurestick_single.kicad_sch, power.kicad_sch, rotation_input.kicad_sch]
2026-09-19 schematic work
    [calipers_in.kicad_sch, lathecontrol_v3.kicad_sch, measurestick_single.kicad_sch]
2026-09-20 more schematic work
    [calipers_in.kicad_sch, lathecontrol_v3.kicad_sch]
2026-09-24 Add Konnect KiCad MCP server config
    Resolves the KiCad 10 3rd-party plugin dir from KICAD10_3RD_PARTY,
    falling back to the Linux default ~/.local/share/kicad/10.0/3rdparty.
2026-09-24 v3: resolve missing footprints, fix part data and datasheet links
    - Add project footprint library lib/footprint.pretty with RP2040-QFN-56,
    USB-C-SMD_TYPE-C-16P-1 and OSC-SMD_4P-L3.2-W2.5-BL (from
    moba-hausbeleuchtung) and USB_A_Upright_C26235 (from v2). Upgraded to
    current format, 3D model paths made project-relative, USB-A footprint
    checked against the C26235 drawing and given a courtyard.
    - U2: EL357N from the old v2 library replaced by stock LTV-817S,
    matching U15-U17.
    - U4 (LM358DR2G): assign SOIC-8_3.9x4.9mm_P1.27mm, checked against
    onsemi case 751-07.
    - U5: switch to W25Q128JVSIQ (C97521, JLC basic part), stock
    Memory_Flash:W25Q128JVS symbol, footprint renamed to
    SOIC-8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
    [calipers_in.kicad_sch, lathecontrol_v3.kicad_sch]
2026-09-24 v3: update PCB from schematic
    Pull the resolved footprints, U2/U4/U5 part changes and new datasheet
    fields into the board. Project file settings as saved by KiCad.
    [lathecontrol_v3.kicad_pcb]
2026-09-24 v3: ignore KiCad local history and lock files
2026-09-26 schematic work (with Opus 5.5)
    [lathecontrol_v3.kicad_sch]
2026-09-26 7-> 6 terminals for vfd output (drop reverse)
    [lathecontrol_v3.kicad_sch]
2026-09-28 schematic bla
    [calipers_in.kicad_sch, lathecontrol_v3.kicad_sch]
